OliverAnthony/GNSS_Speedometer/GNSS_Speedometer.ioc

Mcu.UserName=STM32F103VETx
PA1.Signal=S_TIM5_CH2
PA13.Signal=SYS_JTMS-SWDIO
PA14.Signal=SYS_JTCK-SWCLK
PA2.Signal=USART2_TX
PA3.Signal=USART2_RX
PA5.GPIO_Label=LCD_RST
PA5.Signal=GPIO_Output
PB1.Signal=ADCx_IN9
PB10.Signal=I2C2_SCL
PB11.Signal=I2C2_SDA
PD0.Signal=FSMC_D2
PD1.Signal=FSMC_D3
PD11.Signal=FSMC_A16
PD14.Signal=FSMC_D0
PD15.Signal=FSMC_D1
PD4.Signal=FSMC_NOE
PD5.Signal=FSMC_NWE
PD7.Signal=FSMC_NE1
PD8.Signal=USART3_TX
PD9.Signal=USART3_RX
PE10.Signal=FSMC_D7
PE2.GPIO_Label=GNSS_DET
PE2.Signal=GPIO_Output
PE7.Signal=FSMC_D4
PE8.Signal=FSMC_D5
PE9.Signal=FSMC_D6
