OliverAnthony/GNSS_Speedometer/Core/Inc/main.h

#define TIM_BL htim5
#define UART_PC huart2
#define I2C_ALS hi2c2
#define TIM_VBat htim6
#define UART_GNSS huart3
#define TIM_ALS htim7
#define GNSS_DET_Pin GPIO_PIN_2
#define GNSS_DET_GPIO_Port GPIOE
#define LCD_RST_Pin GPIO_PIN_5
#define LCD_RST_GPIO_Port GPIOA
