OliverAnthony/GNSS_Speedometer/(commit log)

2026-04-12 添加项目文件。
2026-04-17 modified: lv_port_disp.c 添加DMA头文件并移除不必要的代码注释
2026-04-17 feat: Add ALS sensor support and I2C communication
2026-04-17 fix: include "i2c.h"
2026-04-18 feat: Switch MemToMem DMA from DMA1 to DMA2
2026-04-25 fix: Replace UART_GNSS with USART3
    - To avoid DMA conflicts with I2C2
    [GNSS_Speedometer.ioc, main.c, main.h]
2026-04-25 feat: Add DMA support for ALS and enable ALS
2026-04-26 fix: Remove obsolete UART brightness control
    [main.c]
2026-04-26 perf: Increase I2C speed from 100kHz to 400kHz
2026-04-26 fix: Smooth out brightness adjustment
    - Reduce TIM_ALS interrupt interval from 100ms to 20ms
    - Tuned first-order LPF coefficient for screen brightness
    [GNSS_Speedometer.ioc, main.c]
2026-04-26 fix: Disable memory increment for MemToMem DMA
    [GNSS_Speedometer.ioc]
2026-04-26 fix: Use standard HAL macro names
    - Replace __HAL_TIM_GetCompare with __HAL_TIM_GET_COMPARE
    [main.c]
